Eccodyne/Plant-Watering-System/Images/Housing_Front.JPG

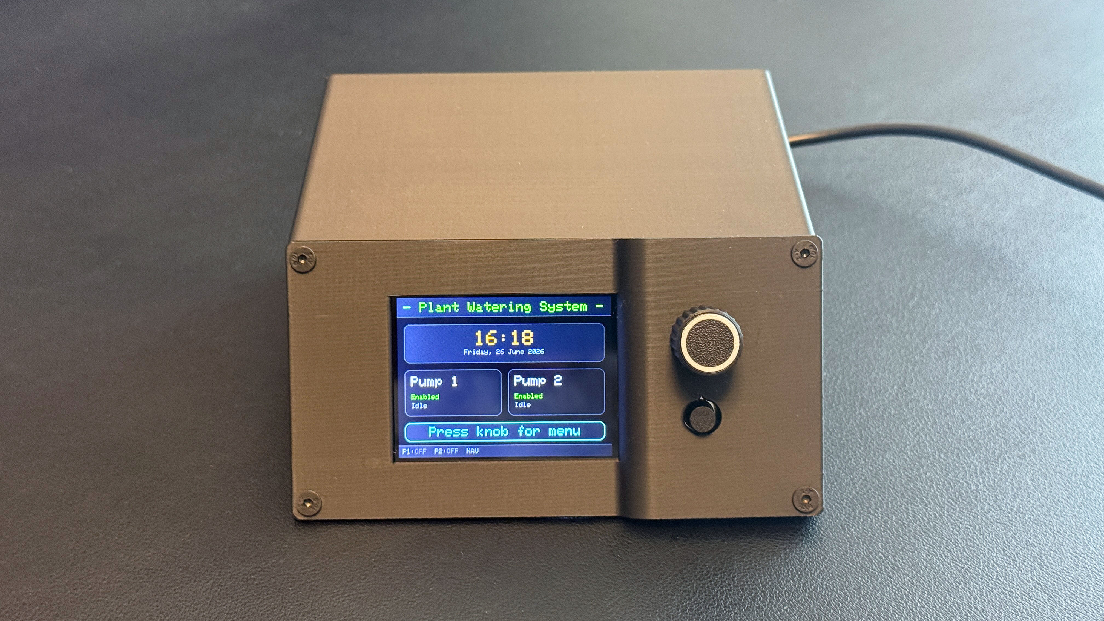
Images/Housing_Front.JPG
