Eccodyne/Plant-Watering-System/(commit log)

2026-06-27 Revise README for Plant Watering System Project
    Updated README to include Garmin G1000 Controller project details, components needed, and 3D printing file links.
2026-06-27 Update assembly instructions in README.md
    Added instructions for attaching relays and LCD display.
2026-06-27 Fix image filename case in README.md
2026-06-27 Fix image link case sensitivity in README.md
2026-06-27 Update README with additional setup instructions
    Added instructions for attaching silicon hoses and filling the water container.
2026-06-27 Update instructions for water pump cable connections
    Clarified instructions for cutting mini plugs from water pump cables.
2026-06-27 Clarify description of M3 screws in README
    Updated wording for clarity regarding the M3 screws.
2026-06-27 Fix links to 3D printing files in README
    Updated links for 3D printing files on Makerworld to point to the correct project.
2026-06-27 Update 3D printing links in README.md
    Updated links for 3D printing files and project instructions.
2026-06-27 Add soldering iron to required items list
    Added soldering iron to the list of required items.
2026-06-27 Fix spelling error in README.md
    Corrected the spelling of 'individual' in the materials list.
2026-06-29 Remove duplicate water pump image
    Removed duplicate water pump image from README.
2026-06-29 Clarify 3D printed housing parts requirements
    Specify filament types for 3D printed parts.
2026-06-29 Clarify description of 3D printed parts needed
    Updated the wording for clarity regarding 3D printed parts.
2026-07-01 Update important usage note in README
    Added a note about using clean water to avoid clogging the pumps.
2026-07-17 Update text color for active/inactive slots
    Change text color based on slot activity status.
2026-07-17 Remove comment on slot activity color coding
    Removed comment about slot activity color coding.
